Alan-JH/precision-clock/precision-clock-pcb/precision-clock.step

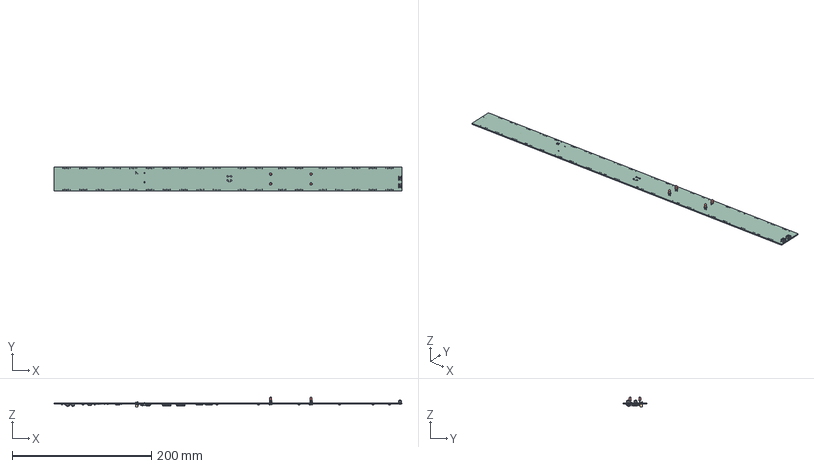
[picture p1: CAD file, 2025-11-18]
precision-clock-pcb/precision-clock.step
500.0 x 34.0 x 14.4 mm
SW_SPST_PTS647Sx38 x 4
LED_D3.0mm x 4
SOT-23 x 14
C_0402_1005Metric x 28
R_0402_1005Metric x 56
C_0603_1608Metric x 2
SOIC-8_5.3x5.3mm_P1.27mm
C_0805_2012Metric x 3
SOIC-8_3.9x4.9mm_P1.27mm
SOIC-20W_7.5x12.8mm_P1.27mm x 2
LED_0603_1608Metric
SOT-666
SOIC-16_3.9x9.9mm_P1.27mm x 2
SOT-223
Crystal_SMD_3225-4Pin_3.2x2.5mm
MMCX_Molex_73415-1471_Vertical
precision-clock_PCB
