Alan-JH/precision-clock/precision-clock-pcb/precision-clock.kicad_pcb

## KiCad design precision-clock-pcb/precision-clock.kicad_pcb (2025-11-18)

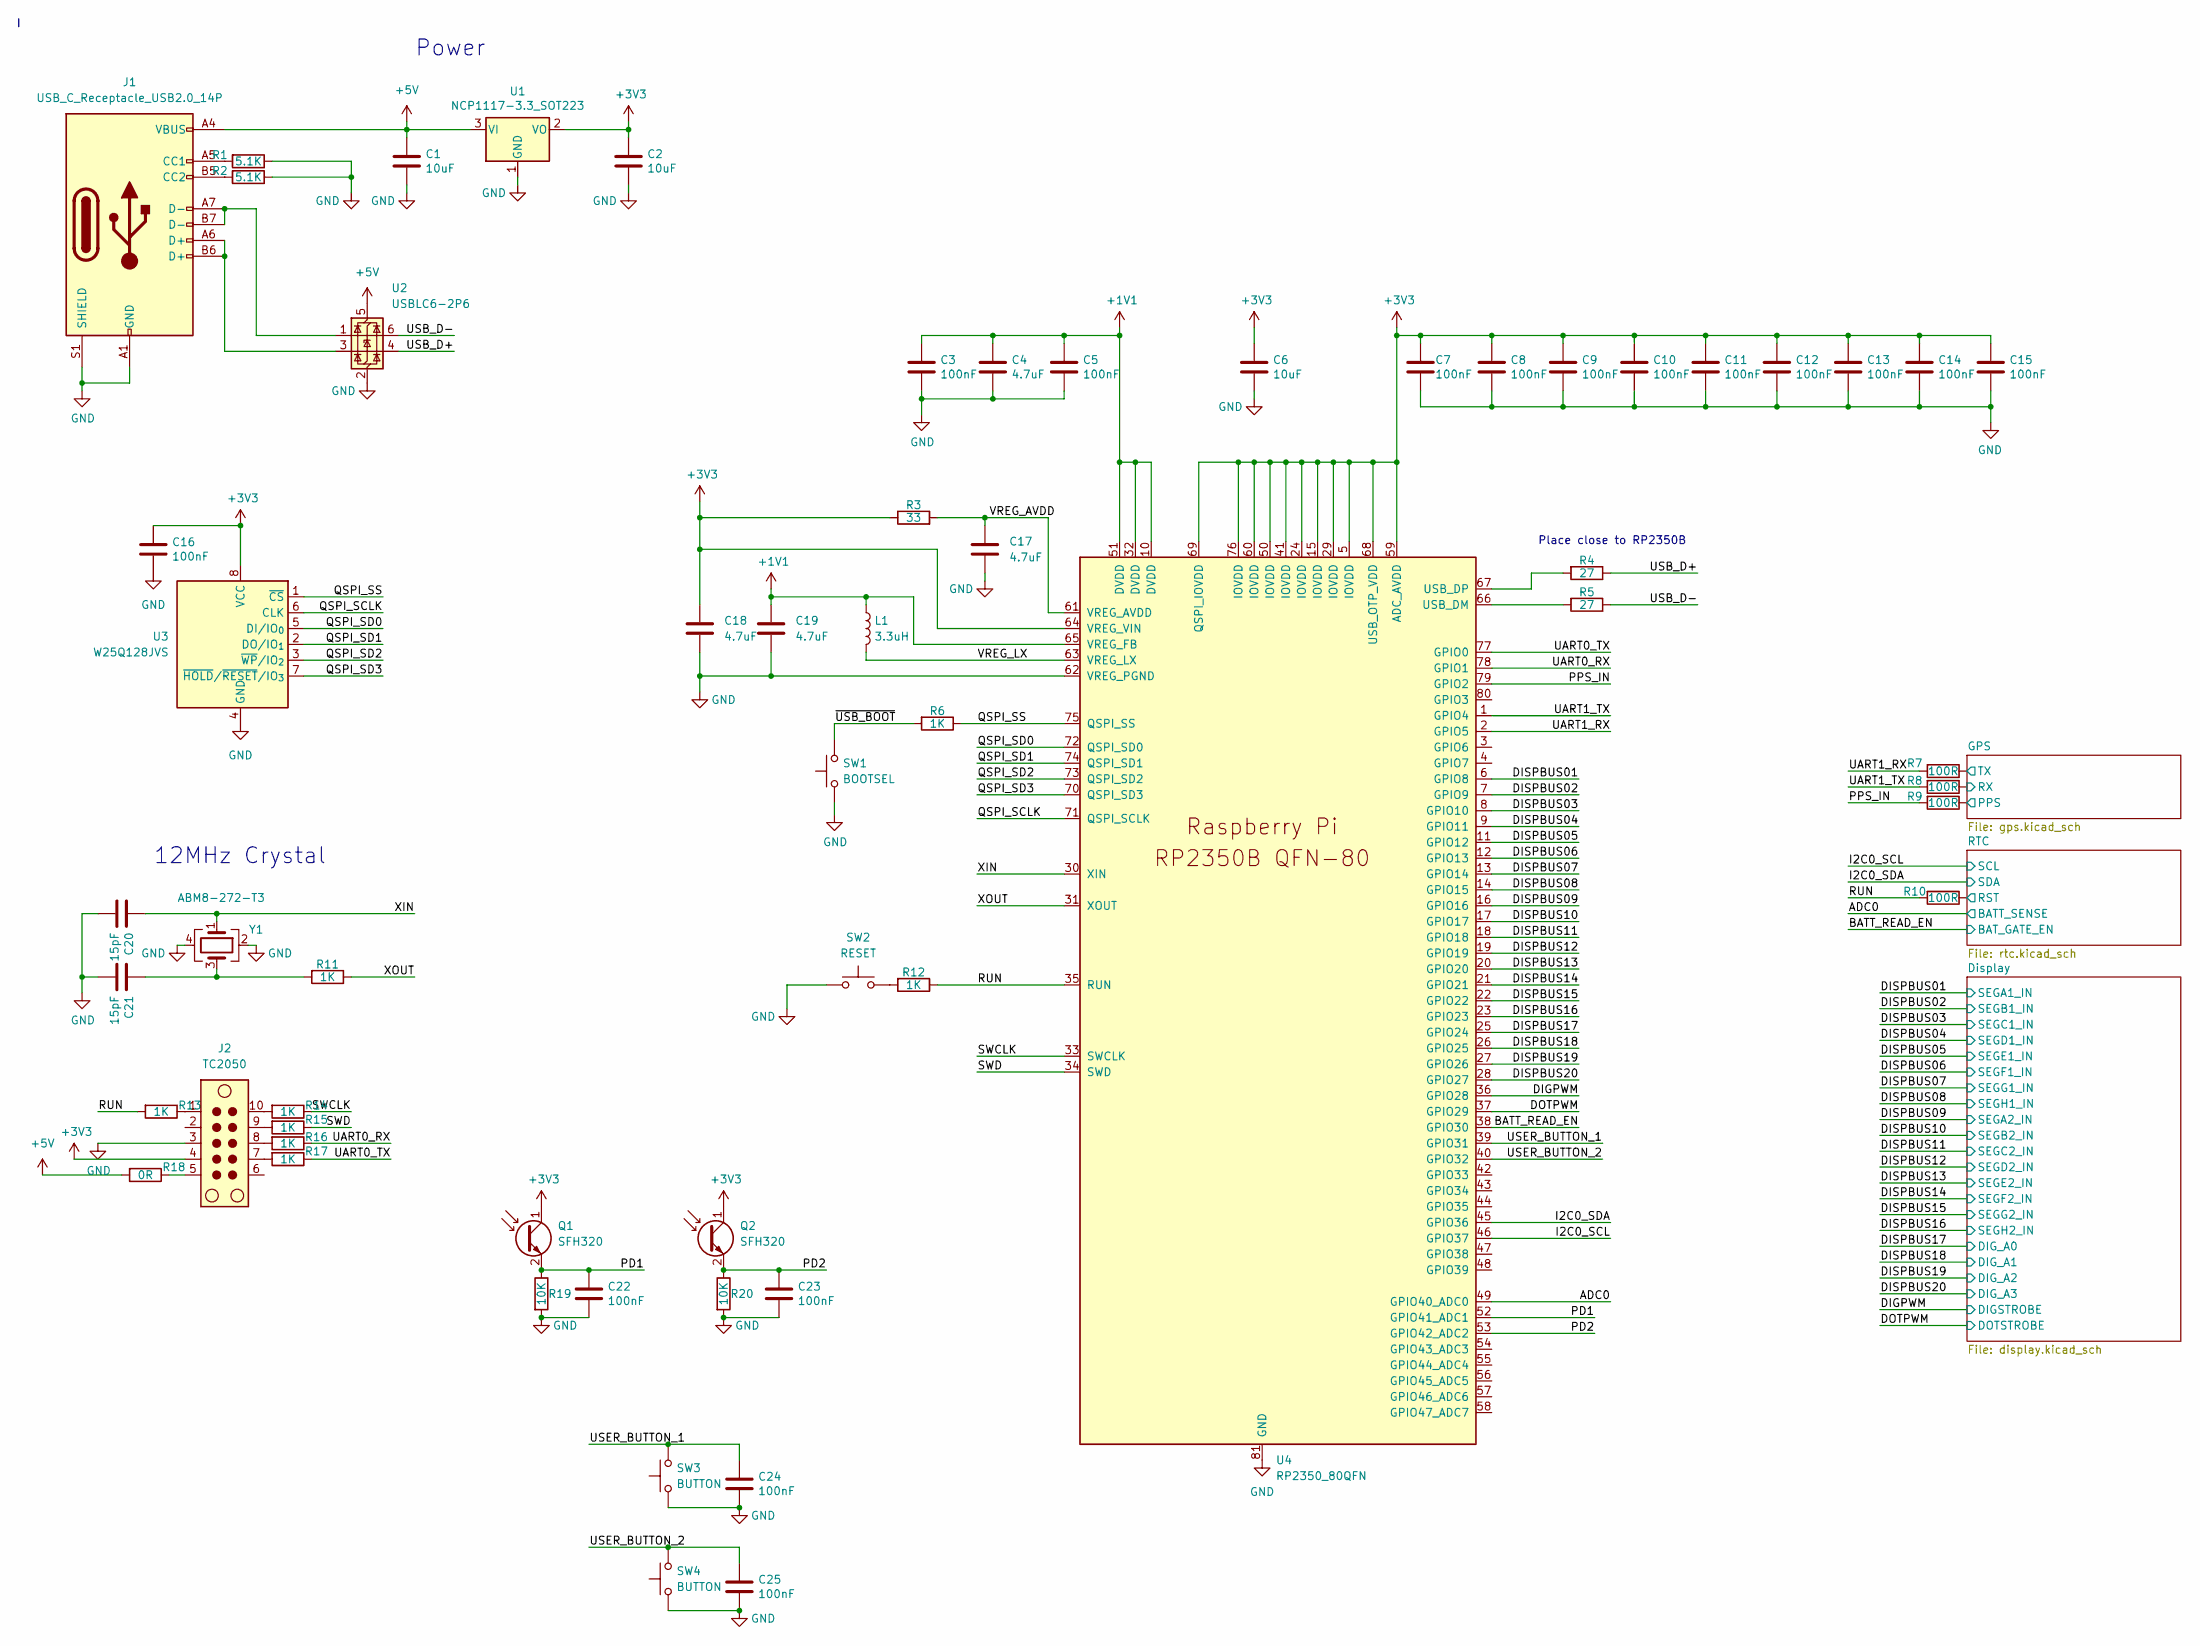
[picture p2: schematic precision-clock.kicad_sch]

Parts:
C1, C2, C6: 10uF; C_0805_2012Metric; MFR PN CL21B106KPQNNNE; JLCPCB PN C32635
C3, C5, C7, C8, C9, C10, C11, C12, C13, C14, C15, C16, C22, C23, C24, C25: 100nF; C_0402_1005Metric; MFR PN GRM155R71E104KE14D; JLCPCB PN C77014
C4, C17: 4.7uF; C_0402_1005Metric; MFR PN GRM155R61A475KEAAD; JLCPCB PN C77004
C18, C19: 4.7uF; C_0402_1005Metric_small_pads; MFR PN GRM155R61A475KEAAD; JLCPCB PN C77004
C20, C21: 15pF; C_0402_1005Metric; MFR PN CGA2B2C0G1H150JT0Y0F; JLCPCB PN C338103
J1: USB_C_Receptacle_USB2.0_14P; USB_C_Receptacle_G-Switch_GT-USB-7010ASV; MFR PN GT-USB-7010ASV; JLCPCB PN C2988369
J2: TC2050; Tag-Connect_TC2050-IDC-FP_2x05_P1.27mm_Vertical
L1: 3.3uH; L_pol_2016; MFR PN AOTA-B201610S3R3-101-T; JLCPCB PN C42411119
Q1, Q2: SFH320; LED_PLCC-2_3.4x3.0mm_KA; MFR PN SFH 320; JLCPCB PN C2900269
R1, R2: 5.1K; R_0402_1005Metric; MFR PN RC0402FR-075K1L; JLCPCB PN C105872
R3: 33; R_0402_1005Metric; MFR PN RC0402FR-0733RL; JLCPCB PN C138002
R4, R5: 27; R_0402_1005Metric; MFR PN RC0402FR-0727RL; JLCPCB PN C138021
R6, R11, R12, R13, R14, R15, R16, R17: 1K; R_0402_1005Metric; MFR PN RC0402FR-071KL; JLCPCB PN C106235
R7, R8, R9, R10: 100R; R_0402_1005Metric; MFR PN RC0402FR-07100RL; JLCPCB PN C106232
R18: 0R; R_0402_1005Metric; MFR PN RC0402FR-070RL; JLCPCB PN C106231
R19, R20: 10K; R_0402_1005Metric; MFR PN RC0402FR-0710KL; JLCPCB PN C60490
SW1: BOOTSEL; SW_SPST_PTS647_Sx38; MFR PN PTS647SK38SMTR2 LFS; JLCPCB PN C2798978
SW2: RESET; SW_SPST_PTS647_Sx38; MFR PN PTS647SK38SMTR2 LFS; JLCPCB PN C2798978
SW3, SW4: BUTTON; SW_SPST_PTS647_Sx38; MFR PN PTS647SK38SMTR2 LFS; JLCPCB PN C2798978
U1: NCP1117-3.3_SOT223; SOT-223-3_TabPin2; MFR PN LM1117MPX-3.3/NOPB; JLCPCB PN C9662
U2: USBLC6-2P6; SOT-666; MFR PN USBLC6-2P6; JLCPCB PN C15999
U3: W25Q128JVS; SOIC-8_5.3x5.3mm_P1.27mm; MFR PN W25Q128JVSIQ; JLCPCB PN C97521
U4: RP2350_80QFN; RP2350-QFN-80-1EP_10x10_P0.4mm_EP3.4x3.4mm_ThermalVias; MFR PN RP2350B; JLCPCB PN C42415655
Y1: ABM8-272-T3; Crystal_SMD_3225-4Pin_3.2x2.5mm; MFR PN ABM8-272-T3; JLCPCB PN C20625731

Connections:
+1V1: C3.1, C4.1, C5.1, C19.1, L1.1, U4.10 (DVDD), U4.32 (DVDD), U4.51 (DVDD), U4.65 (VREG_FB)
+3V3: C2.1, C6.1, C7.1, C8.1, C9.1, C10.1, C11.1, C12.1, C13.1, C14.1, C15.1, C16.1, C18.1, J2.4, Q1.1 (C), Q2.1 (C), R3.1, U1.2 (VO), U3.8 (VCC), U4.5 (IOVDD), U4.15 (IOVDD), U4.24 (IOVDD), U4.29 (IOVDD), U4.41 (IOVDD), U4.50 (IOVDD), U4.59 (ADC_AVDD), U4.60 (IOVDD), U4.64 (VREG_VIN), U4.68 (USB_OTP_VDD), U4.69 (QSPI_IOVDD), U4.76 (IOVDD); also elsewhere on the board
+5V: C1.1, J1.A4 (VBUS), J1.A9 (VBUS), J1.B4 (VBUS), J1.B9 (VBUS), R18.2, U1.3 (VI), U2.5 (VBUS); also elsewhere on the board
/ADC0: U4.49 (GPIO40_ADC0); also elsewhere on the board
/BATT_READ_EN: U4.38 (GPIO30); also elsewhere on the board
/DIGPWM: U4.36 (GPIO28); also elsewhere on the board
/DISPBUS01: U4.6 (GPIO8); also elsewhere on the board
/DISPBUS02: U4.7 (GPIO9); also elsewhere on the board
/DISPBUS03: U4.8 (GPIO10); also elsewhere on the board
/DISPBUS04: U4.9 (GPIO11); also elsewhere on the board
/DISPBUS05: U4.11 (GPIO12); also elsewhere on the board
/DISPBUS06: U4.12 (GPIO13); also elsewhere on the board
/DISPBUS07: U4.13 (GPIO14); also elsewhere on the board
/DISPBUS08: U4.14 (GPIO15); also elsewhere on the board
/DISPBUS09: U4.16 (GPIO16); also elsewhere on the board
/DISPBUS10: U4.17 (GPIO17); also elsewhere on the board
/DISPBUS11: U4.18 (GPIO18); also elsewhere on the board
/DISPBUS12: U4.19 (GPIO19); also elsewhere on the board
/DISPBUS13: U4.20 (GPIO20); also elsewhere on the board
/DISPBUS14: U4.21 (GPIO21); also elsewhere on the board
/DISPBUS15: U4.22 (GPIO22); also elsewhere on the board
/DISPBUS16: U4.23 (GPIO23); also elsewhere on the board
/DISPBUS17: U4.25 (GPIO24); also elsewhere on the board
/DISPBUS18: U4.26 (GPIO25); also elsewhere on the board
/DISPBUS19: U4.27 (GPIO26); also elsewhere on the board
/DISPBUS20: U4.28 (GPIO27); also elsewhere on the board
/DOTPWM: U4.37 (GPIO29); also elsewhere on the board
/GPS/PPS: R9.1; also elsewhere on the board
/GPS/RX: R8.1; also elsewhere on the board
/GPS/TX: R7.1; also elsewhere on the board
/I2C0_SCL: U4.46 (GPIO37); also elsewhere on the board
/I2C0_SDA: U4.45 (GPIO36); also elsewhere on the board
/PD1: C22.1, Q1.2 (E), R19.1, U4.52 (GPIO41_ADC1)
/PD2: C23.1, Q2.2 (E), R20.1, U4.53 (GPIO42_ADC2)
/PPS_IN: R9.2, U4.79 (GPIO2)
/QSPI_SCLK: U3.6 (CLK), U4.71 (QSPI_SCLK)
/QSPI_SD0: U3.5 (DI/IO_{0}), U4.72 (QSPI_SD0)
/QSPI_SD1: U3.2 (DO/IO_{1}), U4.74 (QSPI_SD1)
/QSPI_SD2: U3.3 (~WP/IO_{2}), U4.73 (QSPI_SD2)
/QSPI_SD3: U3.7 (~HOLD/~RESET/IO_{3}), U4.70 (QSPI_SD3)
/QSPI_SS: R6.1, U3.1 (~CS), U4.75 (QSPI_SS)
/RTC/RST: R10.1; also elsewhere on the board
/RUN: R10.2, R12.1, R13.2, U4.35 (RUN)
/SWCLK: R14.1, U4.33 (SWCLK)
/SWD: R15.1, U4.34 (SWD)
/UART0_RX: R16.1, U4.78 (GPIO1)
/UART0_TX: R17.1, U4.77 (GPIO0)
/UART1_RX: R7.2, U4.2 (GPIO5)
/UART1_TX: R8.2, U4.1 (GPIO4)
/USB_D+: R4.1, U2.4 (I/O2)
/USB_D-: R5.1, U2.6 (I/O1)
/USER_BUTTON_1: C24.1, SW3.2, U4.39 (GPIO31)
/USER_BUTTON_2: C25.1, SW4.2, U4.40 (GPIO32)
/VREG_AVDD: C17.1, R3.2, U4.61 (VREG_AVDD)
/VREG_LX: L1.2, U4.63 (VREG_LX)
/XIN: C20.1, U4.30 (XIN), Y1.1
/XOUT: R11.1, U4.31 (XOUT)
/~USB_BOOT: R6.2, SW1.2
GND: C1.2, C2.2, C3.2, C4.2, C5.2, C6.2, C7.2, C8.2, C9.2, C10.2, C11.2, C12.2, C13.2, C14.2, C15.2, C16.2, C17.2, C18.2, C19.2, C20.2, C21.2, C22.2, C23.2, C24.2, C25.2, J1.A1 (GND), J1.A12 (GND), J1.B1 (GND), J1.B12 (GND), J1.S1 (SHIELD), J2.3, R1.1, R2.1, R19.2, R20.2, SW1.1, SW2.1, SW3.1, SW4.1, U1.1 (GND), U2.2 (GND), U3.4 (GND), U4.62 (VREG_PGND), U4.81 (GND), Y1.2, Y1.4; also elsewhere on the board
unnamed: C21.1, R11.2, Y1.3
unnamed: J1.A5 (CC1), R1.2
unnamed: J1.B5 (CC2), R2.2
unnamed: J1.A6 (D+), J1.B6 (D+), U2.3 (I/O2)
unnamed: J1.A7 (D-), J1.B7 (D-), U2.1 (I/O1)
unnamed: J2.1, R13.1
unnamed: J2.5, R18.1
unnamed: J2.7, R17.2
unnamed: J2.8, R16.2
unnamed: J2.9, R15.2
unnamed: J2.10, R14.2
unnamed: R12.2, SW2.2
unnamed: R5.2, U4.66 (USB_DM)
unnamed: R4.2, U4.67 (USB_DP)

Notes on the sheet:
12MHz Crystal
Place close to RP2350B
Power

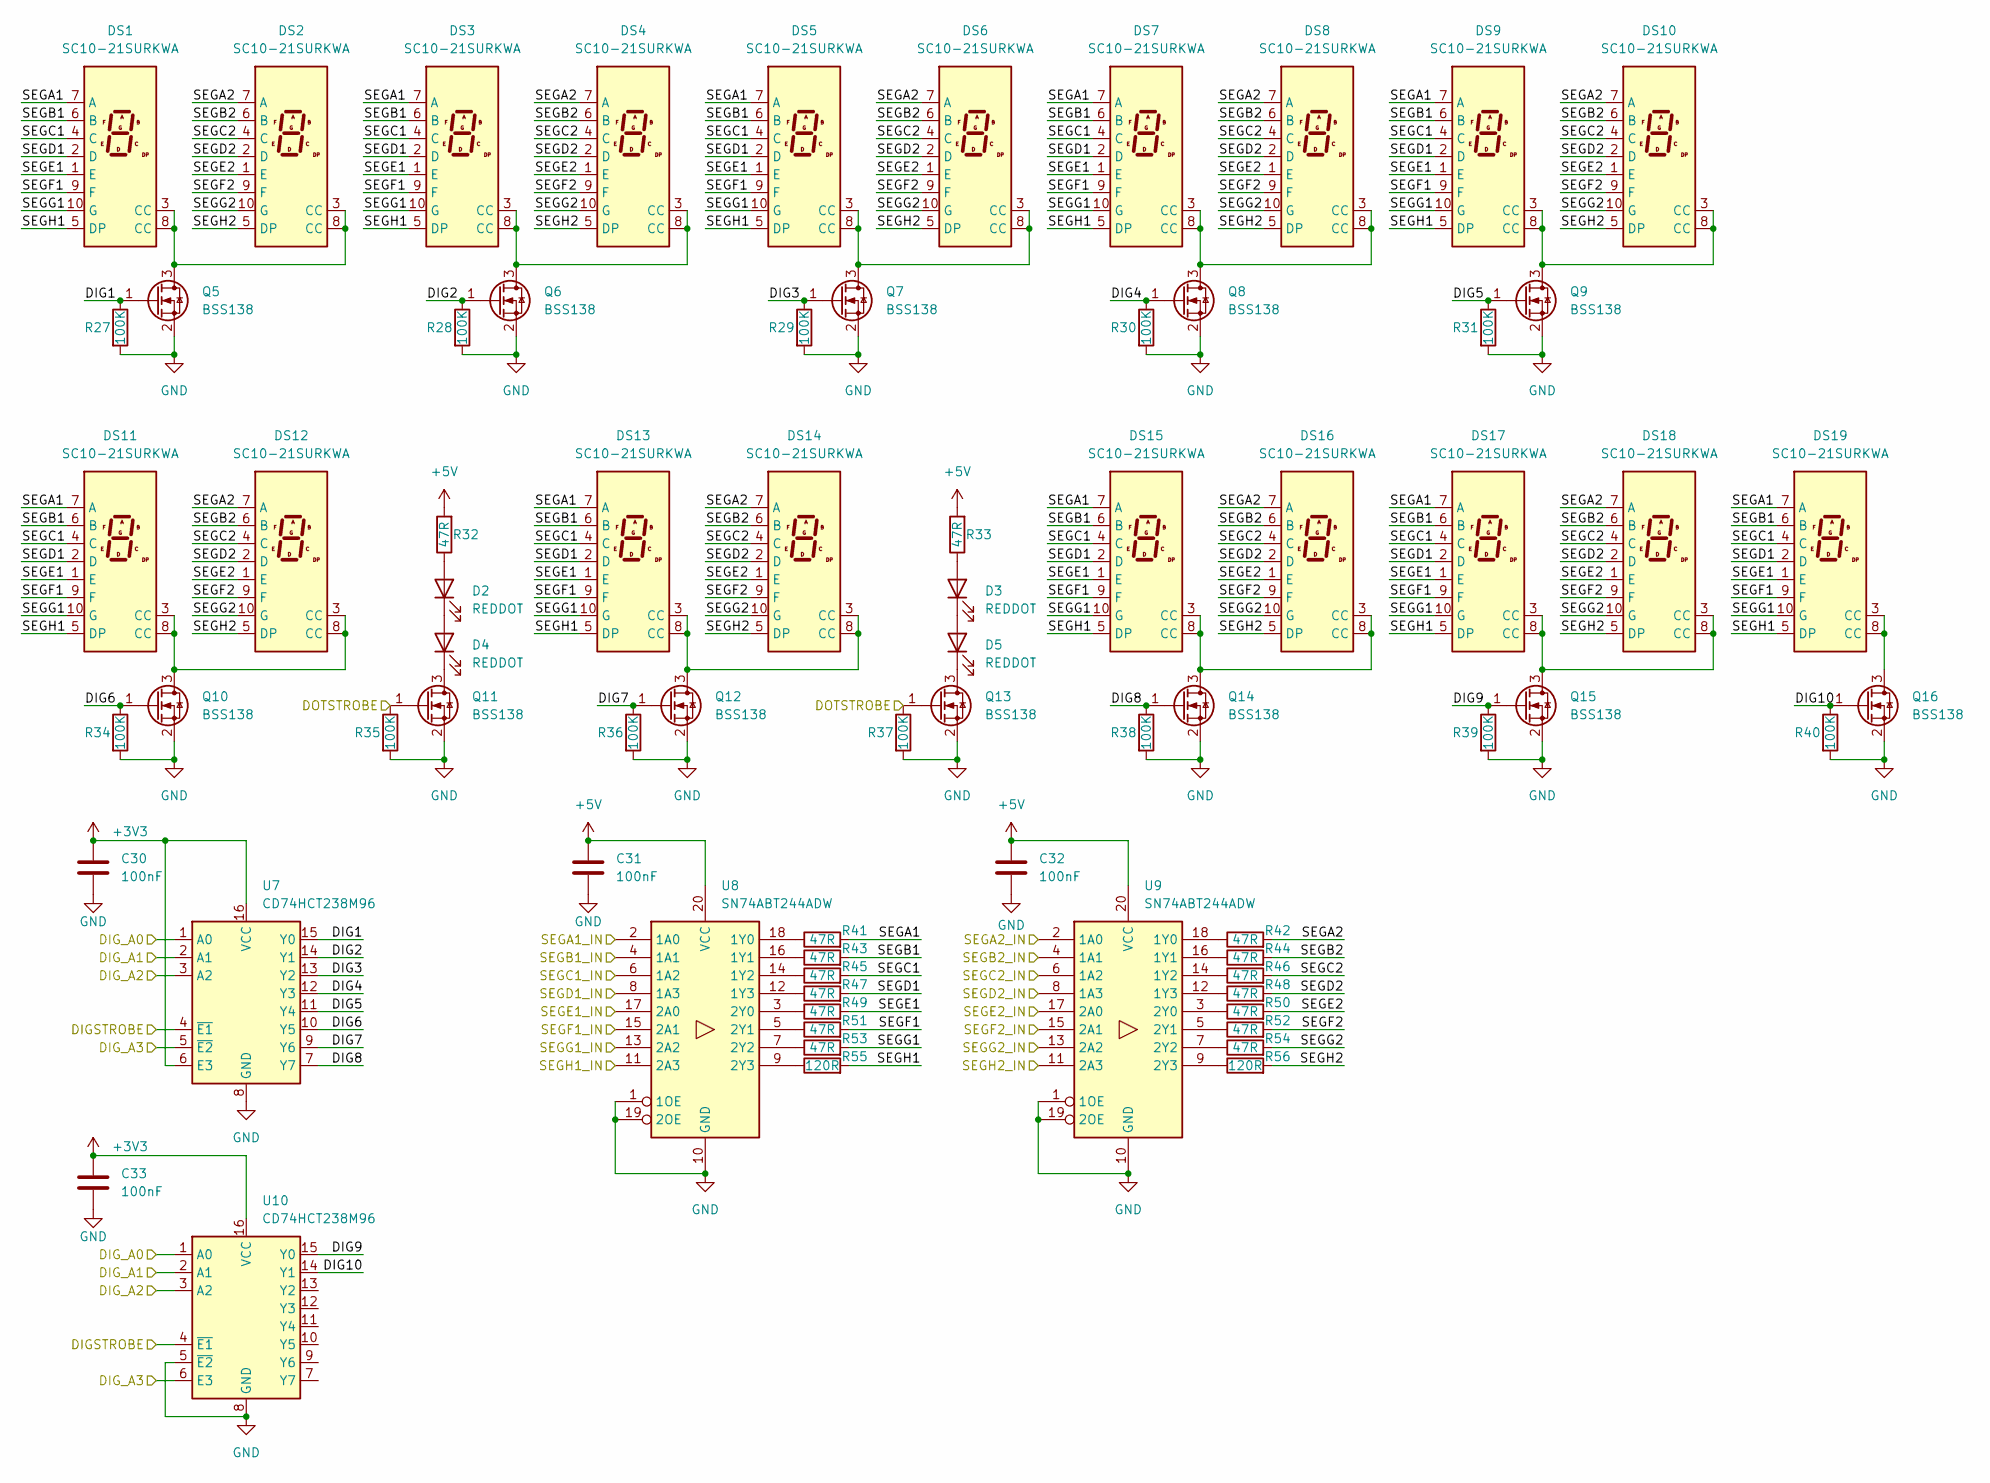
[picture p3: schematic display.kicad_sch]

Parts:
C30, C31, C32, C33: 100nF; C_0402_1005Metric; MFR PN GRM155R71E104KE14D; JLCPCB PN C77014
D2, D3, D4, D5: REDDOT; LED_D3.0mm; MFR PN 204-10SURD/S530-A3-L; JLCPCB PN C99771
DS1, DS2, DS3, DS4, DS5, DS6, DS7, DS8, DS9, DS10, DS11, DS12, DS13, DS14, DS15, DS16, DS17, DS18, DS19: SC10-21SURKWA; MFR PN SC10-21SURKWA; JLCPCB PN C6472270
Q5, Q6, Q7, Q8, Q9, Q10, Q11, Q12, Q13, Q14, Q15, Q16: BSS138; SOT-23; MFR PN BSS138; JLCPCB PN C52895
R27, R28, R29, R30, R31, R34, R35, R36, R37, R38, R39, R40: 100K; R_0402_1005Metric; MFR PN RC0402FR-07100KL; JLCPCB PN C60491
R32, R33, R41, R42, R43, R44, R45, R46, R47, R48, R49, R50, R51, R52, R53, R54: 47R; R_0402_1005Metric; MFR PN RC0402FR-0747RL; JLCPCB PN C137973
R55, R56: 120R; R_0402_1005Metric; MFR PN RC0402FR-07120RL; JLCPCB PN C114758
U7, U10: CD74HCT238M96; SOIC-16_3.9x9.9mm_P1.27mm; MFR PN CD74HCT238M96; JLCPCB PN C553161
U8, U9: SN74ABT244ADW; SOIC-20W_7.5x12.8mm_P1.27mm; MFR PN SN74ABT244ADWR; JLCPCB PN C2675811

Connections:
+3V3: C30.1, C33.1, U7.6 (E3), U7.16 (VCC), U10.16 (VCC); also elsewhere on the board
+5V: C31.1, C32.1, R32.2, R33.2, U8.20 (VCC), U9.20 (VCC); also elsewhere on the board
/DIGPWM: U7.4 (~E1), U10.4 (~E1); also elsewhere on the board
/DISPBUS01: U8.2 (1A0); also elsewhere on the board
/DISPBUS02: U8.4 (1A1); also elsewhere on the board
/DISPBUS03: U8.6 (1A2); also elsewhere on the board
/DISPBUS04: U8.8 (1A3); also elsewhere on the board
/DISPBUS05: U8.17 (2A0); also elsewhere on the board
/DISPBUS06: U8.15 (2A1); also elsewhere on the board
/DISPBUS07: U8.13 (2A2); also elsewhere on the board
/DISPBUS08: U8.11 (2A3); also elsewhere on the board
/DISPBUS09: U9.2 (1A0); also elsewhere on the board
/DISPBUS10: U9.4 (1A1); also elsewhere on the board
/DISPBUS11: U9.6 (1A2); also elsewhere on the board
/DISPBUS12: U9.8 (1A3); also elsewhere on the board
/DISPBUS13: U9.17 (2A0); also elsewhere on the board
/DISPBUS14: U9.15 (2A1); also elsewhere on the board
/DISPBUS15: U9.13 (2A2); also elsewhere on the board
/DISPBUS16: U9.11 (2A3); also elsewhere on the board
/DISPBUS17: U7.1 (A0), U10.1 (A0); also elsewhere on the board
/DISPBUS18: U7.2 (A1), U10.2 (A1); also elsewhere on the board
/DISPBUS19: U7.3 (A2), U10.3 (A2); also elsewhere on the board
/DISPBUS20: U7.5 (~E2), U10.6 (E3); also elsewhere on the board
/DOTPWM: Q11.1 (G), Q13.1 (G), R35.1, R37.1; also elsewhere on the board
/Display/DIG1: Q5.1 (G), R27.1, U7.15 (Y0)
/Display/DIG2: Q6.1 (G), R28.1, U7.14 (Y1)
/Display/DIG3: Q7.1 (G), R29.1, U7.13 (Y2)
/Display/DIG4: Q8.1 (G), R30.1, U7.12 (Y3)
/Display/DIG5: Q9.1 (G), R31.1, U7.11 (Y4)
/Display/DIG6: Q10.1 (G), R34.1, U7.10 (Y5)
/Display/DIG7: Q12.1 (G), R36.1, U7.9 (Y6)
/Display/DIG8: Q14.1 (G), R38.1, U7.7 (Y7)
/Display/DIG9: Q15.1 (G), R39.1, U10.15 (Y0)
/Display/DIG10: Q16.1 (G), R40.1, U10.14 (Y1)
/Display/SEGA1: DS1.7 (A), DS3.7 (A), DS5.7 (A), DS7.7 (A), DS9.7 (A), DS11.7 (A), DS13.7 (A), DS15.7 (A), DS17.7 (A), DS19.7 (A), R41.2
/Display/SEGA2: DS2.7 (A), DS4.7 (A), DS6.7 (A), DS8.7 (A), DS10.7 (A), DS12.7 (A), DS14.7 (A), DS16.7 (A), DS18.7 (A), R42.2
/Display/SEGB1: DS1.6 (B), DS3.6 (B), DS5.6 (B), DS7.6 (B), DS9.6 (B), DS11.6 (B), DS13.6 (B), DS15.6 (B), DS17.6 (B), DS19.6 (B), R43.2
/Display/SEGB2: DS2.6 (B), DS4.6 (B), DS6.6 (B), DS8.6 (B), DS10.6 (B), DS12.6 (B), DS14.6 (B), DS16.6 (B), DS18.6 (B), R44.2
/Display/SEGC1: DS1.4 (C), DS3.4 (C), DS5.4 (C), DS7.4 (C), DS9.4 (C), DS11.4 (C), DS13.4 (C), DS15.4 (C), DS17.4 (C), DS19.4 (C), R45.2
/Display/SEGC2: DS2.4 (C), DS4.4 (C), DS6.4 (C), DS8.4 (C), DS10.4 (C), DS12.4 (C), DS14.4 (C), DS16.4 (C), DS18.4 (C), R46.2
/Display/SEGD1: DS1.2 (D), DS3.2 (D), DS5.2 (D), DS7.2 (D), DS9.2 (D), DS11.2 (D), DS13.2 (D), DS15.2 (D), DS17.2 (D), DS19.2 (D), R47.2
/Display/SEGD2: DS2.2 (D), DS4.2 (D), DS6.2 (D), DS8.2 (D), DS10.2 (D), DS12.2 (D), DS14.2 (D), DS16.2 (D), DS18.2 (D), R48.2
/Display/SEGE1: DS1.1 (E), DS3.1 (E), DS5.1 (E), DS7.1 (E), DS9.1 (E), DS11.1 (E), DS13.1 (E), DS15.1 (E), DS17.1 (E), DS19.1 (E), R49.2
/Display/SEGE2: DS2.1 (E), DS4.1 (E), DS6.1 (E), DS8.1 (E), DS10.1 (E), DS12.1 (E), DS14.1 (E), DS16.1 (E), DS18.1 (E), R50.2
/Display/SEGF1: DS1.9 (F), DS3.9 (F), DS5.9 (F), DS7.9 (F), DS9.9 (F), DS11.9 (F), DS13.9 (F), DS15.9 (F), DS17.9 (F), DS19.9 (F), R51.2
/Display/SEGF2: DS2.9 (F), DS4.9 (F), DS6.9 (F), DS8.9 (F), DS10.9 (F), DS12.9 (F), DS14.9 (F), DS16.9 (F), DS18.9 (F), R52.2
/Display/SEGG1: DS1.10 (G), DS3.10 (G), DS5.10 (G), DS7.10 (G), DS9.10 (G), DS11.10 (G), DS13.10 (G), DS15.10 (G), DS17.10 (G), DS19.10 (G), R53.2
/Display/SEGG2: DS2.10 (G), DS4.10 (G), DS6.10 (G), DS8.10 (G), DS10.10 (G), DS12.10 (G), DS14.10 (G), DS16.10 (G), DS18.10 (G), R54.2
/Display/SEGH1: DS1.5 (DP), DS3.5 (DP), DS5.5 (DP), DS7.5 (DP), DS9.5 (DP), DS11.5 (DP), DS13.5 (DP), DS15.5 (DP), DS17.5 (DP), DS19.5 (DP), R55.2
/Display/SEGH2: DS2.5 (DP), DS4.5 (DP), DS6.5 (DP), DS8.5 (DP), DS10.5 (DP), DS12.5 (DP), DS14.5 (DP), DS16.5 (DP), DS18.5 (DP), R56.2
GND: C30.2, C31.2, C32.2, C33.2, Q5.2 (S), Q6.2 (S), Q7.2 (S), Q8.2 (S), Q9.2 (S), Q10.2 (S), Q11.2 (S), Q12.2 (S), Q13.2 (S), Q14.2 (S), Q15.2 (S), Q16.2 (S), R27.2, R28.2, R29.2, R30.2, R31.2, R34.2, R35.2, R36.2, R37.2, R38.2, R39.2, R40.2, U7.8 (GND), U8.1 (1OE), U8.10 (GND), U8.19 (2OE), U9.1 (1OE), U9.10 (GND), U9.19 (2OE), U10.5 (~E2), U10.8 (GND); also elsewhere on the board
unnamed: D2.2 (A), R32.1
unnamed: D2.1 (K), D4.2 (A)
unnamed: D3.2 (A), R33.1
unnamed: D3.1 (K), D5.2 (A)
unnamed: D4.1 (K), Q11.3 (D)
unnamed: D5.1 (K), Q13.3 (D)
unnamed: DS1.3 (CC), DS1.8 (CC), DS2.3 (CC), DS2.8 (CC), Q5.3 (D)
unnamed: DS3.3 (CC), DS3.8 (CC), DS4.3 (CC), DS4.8 (CC), Q6.3 (D)
unnamed: DS5.3 (CC), DS5.8 (CC), DS6.3 (CC), DS6.8 (CC), Q7.3 (D)
unnamed: DS7.3 (CC), DS7.8 (CC), DS8.3 (CC), DS8.8 (CC), Q8.3 (D)
unnamed: DS9.3 (CC), DS9.8 (CC), DS10.3 (CC), DS10.8 (CC), Q9.3 (D)
unnamed: DS11.3 (CC), DS11.8 (CC), DS12.3 (CC), DS12.8 (CC), Q10.3 (D)
unnamed: DS13.3 (CC), DS13.8 (CC), DS14.3 (CC), DS14.8 (CC), Q12.3 (D)
unnamed: DS15.3 (CC), DS15.8 (CC), DS16.3 (CC), DS16.8 (CC), Q14.3 (D)
unnamed: DS17.3 (CC), DS17.8 (CC), DS18.3 (CC), DS18.8 (CC), Q15.3 (D)
unnamed: DS19.3 (CC), DS19.8 (CC), Q16.3 (D)
unnamed: R41.1, U8.18 (1Y0)
unnamed: R43.1, U8.16 (1Y1)
unnamed: R45.1, U8.14 (1Y2)
unnamed: R47.1, U8.12 (1Y3)
unnamed: R49.1, U8.3 (2Y0)
unnamed: R51.1, U8.5 (2Y1)
unnamed: R53.1, U8.7 (2Y2)
unnamed: R55.1, U8.9 (2Y3)
unnamed: R42.1, U9.18 (1Y0)
unnamed: R44.1, U9.16 (1Y1)
unnamed: R46.1, U9.14 (1Y2)
unnamed: R48.1, U9.12 (1Y3)
unnamed: R50.1, U9.3 (2Y0)
unnamed: R52.1, U9.5 (2Y1)
unnamed: R54.1, U9.7 (2Y2)
unnamed: R56.1, U9.9 (2Y3)

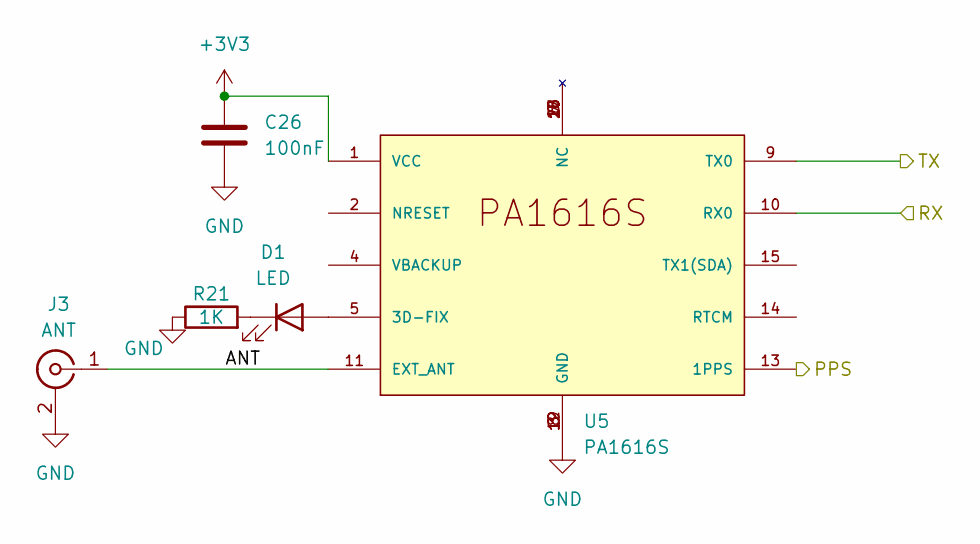
[picture p4: schematic gps.kicad_sch]

Parts:
C26: 100nF; C_0402_1005Metric; MFR PN GRM155R71E104KE14D; JLCPCB PN C77014
D1: LED; LED_0603_1608Metric; MFR PN 150060RS75000; JLCPCB PN C3030991
J3: ANT; MMCX_Molex_73415-1471_Vertical; MFR PN 0734151471; JLCPCB PN C588477
R21: 1K; R_0402_1005Metric; MFR PN RC0402FR-071KL; JLCPCB PN C106235
U5: PA1616S; MFR PN PA1616S

Connections:
+3V3: C26.1, U5.1 (VCC); also elsewhere on the board
/GPS/ANT: J3.1 (In), U5.11 (EXT_ANT)
/GPS/PPS: U5.13 (1PPS); also elsewhere on the board
/GPS/RX: U5.10 (RX0); also elsewhere on the board
/GPS/TX: U5.9 (TX0); also elsewhere on the board
GND: C26.2, J3.2 (Ext), R21.1, U5.3 (GND), U5.8 (GND), U5.12 (GND), U5.19 (GND); also elsewhere on the board
unnamed: D1.2 (A), U5.5 (3D-FIX)
unnamed: D1.1 (K), R21.2

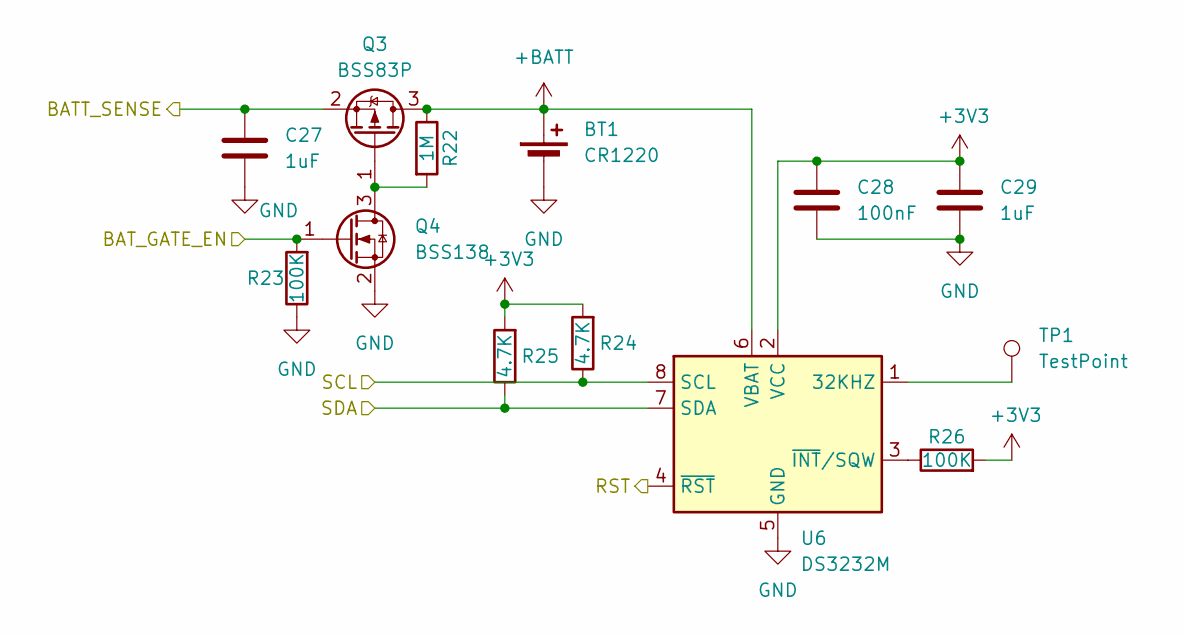
[picture p5: schematic rtc.kicad_sch]

Parts:
BT1: CR1220; BAT_2895; MFR PN 2895; JLCPCB PN C5495443
C27, C29: 1uF; C_0603_1608Metric; MFR PN CL10B105KA8NNNC; JLCPCB PN C29936
C28: 100nF; C_0402_1005Metric; MFR PN GRM155R71E104KE14D; JLCPCB PN C77014
Q3: BSS83P; SOT-23; MFR PN BSS83PH6327; JLCPCB PN C2932927
Q4: BSS138; SOT-23; MFR PN BSS138; JLCPCB PN C52895
R22: 1M; R_0402_1005Metric; MFR PN RC0402FR-071ML; JLCPCB PN C138033
R23, R26: 100K; R_0402_1005Metric; MFR PN RC0402FR-07100KL; JLCPCB PN C60491
R24, R25: 4.7K; R_0402_1005Metric; MFR PN RC0402FR-074K7L; JLCPCB PN C105871
TP1: TestPoint; TestPoint_Pad_2.0x2.0mm
U6: DS3232M; SOIC-8_3.9x4.9mm_P1.27mm; MFR PN DS3232MZ+TRL; JLCPCB PN C2827535

Connections:
+3V3: C28.1, C29.1, R24.2, R25.2, R26.2, U6.2 (VCC); also elsewhere on the board
+BATT: BT1.1 (+), Q3.3 (D), R22.1, U6.6 (VBAT)
/ADC0: C27.1, Q3.2 (S); also elsewhere on the board
/BATT_READ_EN: Q4.1 (G), R23.2; also elsewhere on the board
/I2C0_SCL: R24.1, U6.8 (SCL); also elsewhere on the board
/I2C0_SDA: R25.1, U6.7 (SDA); also elsewhere on the board
/RTC/RST: U6.4 (~RST); also elsewhere on the board
GND: BT1.2 (-), C27.2, C28.2, C29.2, Q4.2 (S), R23.1, U6.5 (GND); also elsewhere on the board
unnamed: Q3.1 (G), Q4.3 (D), R22.2
unnamed: TP1.1, U6.1 (32KHZ)
unnamed: R26.1, U6.3 (~INT/SQW)

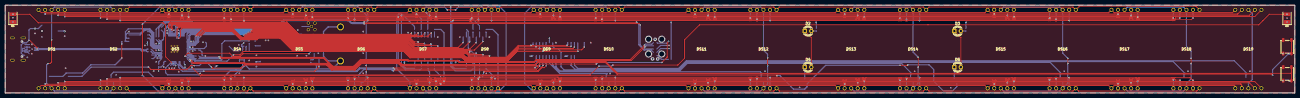
[picture p6: board precision-clock.kicad_pcb from above]

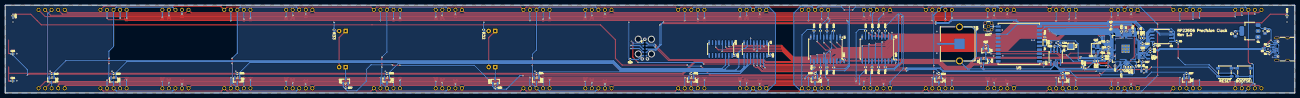
[picture p7: board precision-clock.kicad_pcb from below]

Board: 4 copper layers, 500.0 x 34.0 mm, 150 parts (123 on the bottom side), 138 nets.
