Alan-JH/precision-clock/firmware/src/gps/gps.c

/*
The MIT License (MIT)

Copyright (c) 2015 Jacob McGladdery https://github.com/JCube001/libgps

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
THE SOFTWARE IS PROVIDED "AS IS", WITHOUT WARRANTY OF ANY KIND, EXPRESS OR
IMPLIED, INCLUDING BUT NOT LIMITED TO THE WARRANTIES OF MERCHANTABILITY,
FITNESS FOR A PARTICULAR PURPOSE AND NONINFRINGEMENT. IN NO EVENT SHALL THE
AUTHORS OR COPYRIGHT HOLDERS BE LIABLE FOR ANY CLAIM, DAMAGES OR OTHER
LIABILITY, WHETHER IN AN ACTION OF CONTRACT, TORT OR OTHERWISE, ARISING FROM,
OUT OF OR IN CONNECTION WITH THE SOFTWARE OR THE USE OR OTHER DEALINGS IN
THE SOFTWARE.
*/

#include "gps.h"

#include <assert.h>
#include <stdbool.h>
#include <stddef.h>
#include <string.h>

#define NMEA_MAX_FIELDS  (32)
#define SENTENCE_ID_SIZE (3)

#define is_char_in_range(c, start, end) \
    (((uint_fast8_t)(c - start)) < ((uint_fast8_t)(end - start + 1)))

#define is_digit_0_to_1(c) is_char_in_range(c, '0', '1')
#define is_digit_0_to_2(c) is_char_in_range(c, '0', '2')
#define is_digit_0_to_3(c) is_char_in_range(c, '0', '3')
#define is_digit_0_to_5(c) is_char_in_range(c, '0', '5')
#define is_digit_0_to_9(c) is_char_in_range(c, '0', '9')

typedef uint8_t (*parse_function)(struct gps_tpv *, const char **);

static const char NULL_TIME[] = "0000-00-00T00:00:00.000Z";

static char uint8_to_hex_char(const uint8_t n)
{
    static const char hex[] = {
        '0', '1', '2', '3', '4', '5', '6', '7',
        '8', '9', 'A', 'B', 'C', 'D', 'E', 'F'
    };

    if ((0 <= n) && (n <= 0x0F)) return hex[n];
    return hex[0];
}

static uint8_t hex_char_to_uint8(const char c)
{
    if (('0' <= c) && (c <= '9'))
        return c - '0';
    else if (('A' <= c) && (c <= 'F'))
        return c - 'A' + 10;
    else if (('a' <= c) && (c <= 'f'))
        return c - 'a' + 10;

    return 0;
}

static uint8_t build_hex_byte(const char c0, const char c1)
{
    uint8_t val;
    val  = (hex_char_to_uint8(c0) << 4) & 0xF0;
    val |=  hex_char_to_uint8(c1)       & 0x0F;
    return val;
}

static bool match_sentence_id(const char *str, const char *id)
{
    return strncmp(str, id, SENTENCE_ID_SIZE) == 0;
}

static int32_t parse_number(const char *str)
{
    int32_t value = 0;
    int32_t factor;
    int32_t sign = 1;
    char c0 = *str++;

    /* Check if the string is an empty token field */
    if (!c0) return GPS_INVALID_VALUE;

    /* Number : -?[0-9]+(\.[0-9]{1,3}) */

    /* Check if the first character is a minus sign
     * Regex : -?
     */
    if ('-' == c0)
    {
        sign = -1;
        c0 = *str++;
    }

    /* Store one or more decimal digits
     * Regex : [0-9]+
     */
    if (is_digit_0_to_9(c0))
    {
        do
        {
            value = (value * 10) + (c0 - '0');
            c0 = *str++;
        }
        while (is_digit_0_to_9(c0));
    }
    else
    {
        return GPS_INVALID_VALUE;
    }

    /* Check for a decimal point. If one is present, then store up to 3 digits
     * past it.
     * Regex : (\.[0-9]{1,3})
     */
    factor = GPS_VALUE_FACTOR;
    if ('.' == c0)
    {
        c0 = *str++;
        if (is_digit_0_to_9(c0))
        {
            uint_fast8_t i = 3;

            do
            {
                value = (value * 10) + (c0 - '0');
                factor /= 10;
                c0 = *str++;
            }
            while (is_digit_0_to_9(c0) && --i);
        }
    }

    return value * factor * sign;
}

static int32_t parse_angular_distance(const char *nmea, const char direction)
{
    int32_t angular_distance;
    int32_t minutes;
    int32_t factor;
    int32_t sign;
    uint_fast8_t i;
    char c0 = *nmea++;

    /* First check for an empty token field */
    if (!c0) return GPS_INVALID_VALUE;

    /* Latitude  : ([0-9]{2})([0-9]{2}\.)[0-9]{1,6}
     * Longitude : ([0-9]{3})([0-9]{2}\.)[0-9]{1,6}
     *
     * Northing  : N = +, S = -
     * Easting   : E = +, W = -
     */

    /* Convert the direction to a sign. Also set the number of digits to treat
     * as decimal degrees. For N or S, we know we are parsing latitude and
     * that begins with 2 degree digits. For E or W, we know we are parsing
     * longitude and that begins with 3 degree digits.
     */
    switch (direction)
    {
    case 'N':
        sign = 1;
        i = 2;
        break;
    case 'S':
        sign = -1;
        i = 2;
        break;
    case 'E':
        sign = 1;
        i = 3;
        break;
    case 'W':
        sign = -1;
        i = 3;
        break;
    default:
        return GPS_INVALID_VALUE;
    }

    /* Store the first 3 digits which are already in decimal degrees
     * Regex : ([0-9]{3})
     */
    angular_distance = 0;
    while (i--)
    {
        if (is_digit_0_to_9(c0))
        {
            angular_distance = (angular_distance * 10) + (c0 - '0');
            c0 = *nmea++;
        }
        else
        {
            return GPS_INVALID_VALUE;
        }
    }
    angular_distance *= GPS_LAT_LON_FACTOR;

    /* Store the next two digits which are part of the arc minutes
     * Regex : ([0-9]{2}\.)
     */
    minutes = 0;
    i = 2;
    while (i--)
    {
        if (is_digit_0_to_9(c0))
        {
            minutes = (minutes * 10) + (c0 - '0');
            c0 = *nmea++;
        }
        else
        {
            return GPS_INVALID_VALUE;
        }
    }

    /* Check if a decimal point is the current character */
    if (c0 != '.') return GPS_INVALID_VALUE;
    c0 = *nmea++;

    /* Store up to 6 more arc minute fraction values
     * Regex : [0-9]{1,6}
     */
    factor = GPS_LAT_LON_FACTOR;
    i = 6;
    if (is_digit_0_to_9(c0))
    {
        do
        {
            minutes = (minutes * 10) + (c0 - '0');
            factor /= 10;
            c0 = *nmea++;
        }
        while (is_digit_0_to_9(c0) && --i);
    }
    else
    {
        return GPS_INVALID_VALUE;
    }
    minutes *= factor;

    /* Divide the arc minutes by 60 to get the decimal degrees fraction */
    minutes /= 60;

    /* Add the decimal degrees to the fraction component. We now how an
     * integer value which represents latitude in decimal degrees times
     * 10^6.
     */
    angular_distance += minutes;

    return angular_distance * sign;
}

static uint8_t parse_time(Time *destination, const char *nmea)
{
    char c0 = *nmea++;

    /* ISO8601 : YYYY-MM-DDTHH:MM:SS.SSSZ
     * NMEA    : HHMMSS.SSS
     * Regex   : ([0-2][0-9])([0-5][0-9])([0-5][0-9])(\.[0-9]{1,3})?
     */

    /* ([0-2][0-9]) */
    if (is_digit_0_to_2(c0))
    {
        destination->hours = 10 * (uint8_t)(c0 - '0'); /* H */
        c0 = *nmea++;
    }
    else
    {
        return 1;
    }

    if (is_digit_0_to_9(c0))
    {
        destination->hours += (uint8_t)(c0 - '0'); /* H */
        c0 = *nmea++;
    }
    else
    {
        return 1;
    }

    /* ([0-5][0-9]) */
    if (is_digit_0_to_5(c0))
    {
        destination->minutes = 10 * (uint8_t)(c0 - '0'); /* M */
        c0 = *nmea++;
    }
    else
    {
        return 1;
    }

    if (is_digit_0_to_9(c0))
    {
        destination->minutes += (uint8_t)(c0 - '0'); /* M */
        c0 = *nmea++;
    }
    else
    {
        return 1;
    }

    /* ([0-5][0-9]) */
    if (is_digit_0_to_5(c0))
    {
        destination->seconds = 10 * (uint8_t)(c0 - '0'); /* S */
        c0 = *nmea++;
    }
    else
    {
        return 1;
    }

    if (is_digit_0_to_9(c0))
    {
        destination->seconds += (uint8_t)(c0 - '0'); /* S */
        c0 = *nmea++;
    }
    else
    {
        return 1;
    }

    /* (\.[0-9]{1,3})? */
    destination->milliseconds = 0;
    if ('.' == c0)
    {
        uint_fast8_t i;

        /* Advance the destination pointer past the decimal point */
        destination += 20;
        c0 = *nmea++;
        uint8_t factor = 100;
        for (i = 0; is_digit_0_to_9(c0) && (i < 3); ++i)
        {
            destination->milliseconds += (uint8_t)(c0 - '0') * factor;
            factor /= 10;
            c0 = *nmea++;
        }
    }
    return 0;
}

static uint8_t parse_date(Time *destination, const char *nmea)
{
    char c0 = *nmea++;

    /* ISO8601 : YYYY-MM-DDTHH:MM:SS.SSSZ
     * NMEA    : DDMMYY
     * Regex   : ([0-3][0-9])([0-1][0-9])([0-9][0-9])
     */

    /* ([0-3][0-9]) */
    if (is_digit_0_to_3(c0))
    {
        destination->date = 10 * (uint8_t)(c0 - '0'); /* D */
        c0 = *nmea++;
    }
    else
    {
        return 1;
    }

    if (is_digit_0_to_9(c0))
    {
        destination->date += (uint8_t)(c0 - '0'); /* D */
        c0 = *nmea++;
    }
    else
    {
        return 1;
    }

    /* ([0-1][0-9]) */
    if (is_digit_0_to_1(c0))
    {
        destination->month = 10 * (uint8_t)(c0 - '0'); /* M */
        c0 = *nmea++;
    }
    else
    {
        return 1;
    }

    if (is_digit_0_to_9(c0))
    {
        destination->month += (uint8_t)(c0 - '0'); /* M */
        c0 = *nmea++;
    }
    else
    {
        return 1;
    }

    /* ([0-9][0-9]) */
    destination->year = 2000; /* Prepend "20" to the year. Hopefully by the year 2100 there will be a
     * better standard than NMEA 0183 and we will never need to change this.
     */
    if (is_digit_0_to_9(c0))
    {
        destination->year += 10 * (uint8_t)(c0 - '0'); /* Y */
        c0 = *nmea++;
    }
    else
    {
        return 1;
    }

    if (is_digit_0_to_9(c0))
    {
        destination->year += (uint8_t)(c0 - '0'); /* Y */
        c0 = *nmea++;
    }
    else
    {
        return 1;
    }
    return 0;
}

static uint8_t parse_extended_date(Time *destination, const char *day, const char *month, const char *year)
{
    uint_fast8_t i;
    char c0;

    /* ISO8601 : YYYY-MM-DDTHH:MM:SS.SSSZ
     * Day     : [0-3][0-9]
     * Month   : [0-1][0-9]
     * Year    : [0-9]{4}
     */

    /* Day */
    c0 = *day++;
    if (is_digit_0_to_3(c0))
    {
        destination->date = 10 * (uint8_t)(c0 - '0');
        c0 = *day++;
    }
    else
    {
        return 1;
    }

    if (is_digit_0_to_9(c0))
    {
        destination->date += (uint8_t)(c0 - '0');
    }
    else
    {
        return 1;
    }

    /* Month */
    c0 = *month++;
    if (is_digit_0_to_1(c0))
    {
        destination->month = 10 * (uint8_t)(c0 - '0');
        c0 = *month++;
    }
    else
    {
        return 1;
    }

    if (is_digit_0_to_9(c0))
    {
        destination->month += (uint8_t)(c0 - '0');
    }
    else
    {
        return 1;
    }

    /* Year */
    c0 = *year++;
    uint16_t factor = 1000;
    destination->year = 0;
    for (i = 0; is_digit_0_to_9(c0) && (i < 4); ++i)
    {
        destination->year += factor * (uint8_t)(c0 - '0');
        c0 = *year++;
        factor /= 10;
    }
    return 0;
}

static int32_t parse_altitude(const char *nmea, const char unit)
{
    /* The unit should always be meters */
    if (unit != 'M') return GPS_INVALID_VALUE;

    return parse_number(nmea);
}

static int32_t parse_track(const char *nmea, const char type)
{
    /* Make sure the track type is true */
    if (type != 'T') return GPS_INVALID_VALUE;

    return parse_number(nmea);
}

static int32_t parse_speed(const char *nmea, const char unit)
{
    int32_t speed;

    /* Process speed differently based on the unit. In all cases, we are
     * converting from some unit to the SI unit of meters per second.
     * K = Kilometers per hour, N = Knots
     */
    switch (unit)
    {
    case 'K':
        speed = parse_number(nmea);
        return (speed * 10) / 36;
    case 'N':
        speed = parse_number(nmea);
        return (speed * 1000) / 1944;
    default:
        break;
    }

    return GPS_INVALID_VALUE;
}

static enum gps_mode parse_mode(const char mode)
{
    switch (mode)
    {
    case '1': return GPS_MODE_NO_FIX;
    case '2': return GPS_MODE_2D_FIX;
    case '3': return GPS_MODE_3D_FIX;
    default: break;
    }

    return GPS_MODE_UNKNOWN;
}

static bool is_status_valid(const char status)
{
    if ('A' == status) return true;
    return false;
}

static uint8_t parse_gga(struct gps_tpv *tpv, const char **token)
{
    if (parse_time(tpv->time, token[0])) return GPS_ERROR_PARSE;
    tpv->latitude = parse_angular_distance(token[1], token[2][0]);
    tpv->longitude = parse_angular_distance(token[3], token[4][0]);
    tpv->altitude = parse_altitude(token[8], token[9][0]);
    return 0;
}

static uint8_t parse_gll(struct gps_tpv *tpv, const char **token)
{
    if (is_status_valid(token[5][0]))
    {
        tpv->latitude = parse_angular_distance(token[0], token[1][0]);
        tpv->longitude = parse_angular_distance(token[2], token[3][0]);
        if (parse_time(tpv->time, token[4])) return GPS_ERROR_PARSE;
        return 0;
    }
    return GPS_ERROR_PARSE;
}

static uint8_t parse_gsa(struct gps_tpv *tpv, const char **token)
{
    tpv->mode = parse_mode(token[1][0]);
    return 0;
}

static uint8_t parse_rmc(struct gps_tpv *tpv, const char **token)
{
    if (is_status_valid(token[1][0]))
    {
        if (parse_time(tpv->time, token[0])) return GPS_ERROR_PARSE;
        tpv->latitude = parse_angular_distance(token[2], token[3][0]);
        tpv->longitude = parse_angular_distance(token[4], token[5][0]);
        tpv->track = parse_track(token[7], 'T');
        tpv->speed = parse_speed(token[6], 'N');
        if (parse_date(tpv->time, token[8])) return GPS_ERROR_PARSE;
        return 0;
    }
    return GPS_ERROR_PARSE;
}

static uint8_t parse_vtg(struct gps_tpv *tpv, const char **token)
{
    tpv->track = parse_track(token[0], token[1][0]);
    tpv->speed = parse_speed(token[6], token[7][0]);
    return 0;
}

static uint8_t parse_zda(struct gps_tpv *tpv, const char **token)
{
    if (parse_time(tpv->time, token[0])) return GPS_ERROR_PARSE;
    if (parse_extended_date(tpv->time, token[1], token[2], token[3])) return GPS_ERROR_PARSE;
    return 0;
}

void gps_init_tpv(struct gps_tpv *tpv)
{
    assert(tpv != NULL);

    tpv->mode      = GPS_MODE_UNKNOWN;
    tpv->altitude  = GPS_INVALID_VALUE;
    tpv->latitude  = GPS_INVALID_VALUE;
    tpv->longitude = GPS_INVALID_VALUE;
    tpv->track     = GPS_INVALID_VALUE;
    tpv->speed     = GPS_INVALID_VALUE;
    tpv->time->date = DEFAULT_DATE;
    tpv->time->month = DEFAULT_MONTH;
    tpv->time->year = DEFAULT_YEAR;
    tpv->time->hours = 0;
    tpv->time->minutes = 0;
    tpv->time->seconds = 0;
    tpv->time->milliseconds = 0;
    memset(tpv->talker_id, '\0', GPS_TALKER_ID_SIZE);
}

char *gps_encode(char *destination, const char *message)
{
    assert(destination != NULL);
    assert(message != NULL);

    uint8_t checksum = 0;
    char c0 = *message++;

    /* Add the header character */
    *destination++ = '$';

    /* Add and compute the checksum for all of the message contents */
    while (c0)
    {
        checksum ^= c0;
        *destination++ = c0;
        c0 = *message++;
    }

    /* Add the end of sentence marker */
    *destination++ = '*';

    /* Add the checksum characters */
    *destination++ = uint8_to_hex_char((checksum & 0xF0) >> 4);
    *destination++ = uint8_to_hex_char( checksum & 0x0F);

    /* Add the footer characters */
    *destination++ = '\r';
    *destination++ = '\n';

    /* NUL terminate the string */
    *destination = '\0';

    return destination;
}

int gps_decode(struct gps_tpv *tpv, char *nmea)
{
    assert(tpv != NULL);
    assert(nmea != NULL);

    parse_function parse;
    char *token[NMEA_MAX_FIELDS];
    uint8_t checksum = 0;
    uint8_t i = 0;
    char c0 = *nmea++;
    char c1;

    /* Check if the first character is the header */
    if (c0 != '$') return GPS_ERROR_HEAD;
    c0 = *nmea++;

    /* Store the talker ID */
    c1 = *nmea++;
    if (!c0 || !c1) return GPS_ERROR_TRUNCATED;
    tpv->talker_id[0] = c0;
    tpv->talker_id[1] = c1;

    /* Compute the checksum thus far */
    checksum ^= c0 ^ c1;

    /* Use the sentence ID to determine which parsing function to use */
    /* TODO: Switch checking for sentences on and off using # defines and a config.h */
    if (memchr(nmea, '\0', SENTENCE_ID_SIZE))
        return GPS_ERROR_TRUNCATED;
    else if (match_sentence_id(nmea, "GGA"))
        parse = parse_gga;
    else if (match_sentence_id(nmea, "GLL"))
        parse = parse_gll;
    else if (match_sentence_id(nmea, "GSA"))
        parse = parse_gsa;
    else if (match_sentence_id(nmea, "RMC"))
        parse = parse_rmc;
    else if (match_sentence_id(nmea, "VTG"))
        parse = parse_vtg;
    else if (match_sentence_id(nmea, "ZDA"))
        parse = parse_zda;
    else
        return GPS_ERROR_UNSUPPORTED;

    /* Advance c0 to the first character in the sentence ID. This also syncs
     * the NMEA string pointer with the current character being processed.
     * This helps to make the tokenizing stage easier to maintain.
     */
    c0 = *nmea;

    /* Tokenize and compute the checksum for the body of the NMEA sentence.
     * Note that tokenizing begins after the first ',' is encountered. This
     * works because the sentence ID is the first string processed and we do
     * not need to store it as a token.
     */
    while (c0 != '*')
    {
        if (!c0) return GPS_ERROR_TRUNCATED;
        checksum ^= c0;
        if (',' == c0)
        {
            *nmea = '\0';
            token[i++] = nmea + 1;
        }
        c0 = (++nmea)[0];
    }

    /* Replace the '*' with a NUL in order to mark the end of the final token
     * in the sentence. Then advance the pointer nmea one position ahead
     * again.
     */
    *nmea++ = '\0';
    c0 = *nmea++;

    /* Validate the checksum */
    c1 = *nmea++;
    if (checksum != build_hex_byte(c0, c1)) return GPS_ERROR_CHECKSUM;
    c0 = *nmea++;

    /* Check for the message footer */
    c1 = *nmea++;
    if ((c0 != '\r') || (c1 != '\n')) return GPS_ERROR_FOOT;

    /* Parse the NMEA sentence tokens */
    if (parse(tpv, (const char **)token))
        return GPS_ERROR_PARSE;

    return GPS_OK;
}

const char *gps_error_string(const int e)
{
    static const char *msg[] = {
        "No error while parsing NMEA",
        "Header '$' missing",
        "Footer CRLF missing",
        "Checksum did not match",
        "Sentence truncated",
        "Unsupported NMEA sentence"
    };

    if ((0 <= e) && (e < ((int)(sizeof(msg) / sizeof(msg[0]))))) return msg[e];
    return "Unknown error";
}
