Alan-JH/precision-clock/(commit log)

2025-11-06 Revert "Initial commit"
    This reverts commit 37d97fef083f5c2f4647276c4944423df487484e.
    [display.kicad_sch, gps.kicad_sch, precision-clock.kicad_pcb, precision-clock.kicad_sch, rtc.kicad_sch]
2025-11-06 Revert "Revert "Initial commit""
    This reverts commit 25a4185e54c432d465cfb9da8a8ced92ea69207e.
    [display.kicad_sch, gps.kicad_sch, precision-clock.kicad_pcb, precision-clock.kicad_sch, rtc.kicad_sch]
2025-11-11 display work
    [display.kicad_sch]
2025-11-12 schematic work done
    [display.kicad_sch, gps.kicad_sch, precision-clock.kicad_sch, rtc.kicad_sch]
2025-11-14 ADC Backup Battery
2025-11-14 board work
    [display.kicad_sch, gps.kicad_sch, precision-clock.kicad_pcb, precision-clock.kicad_sch, rtc.kicad_sch]
2025-11-15 Board Rev 1.0 Release
    [gps.kicad_sch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]
2025-11-18 BOM, CSV, and STEP exports
    [display.kicad_sch, gps.kicad_sch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]
2025-11-18 fix bom and recompress gerbers
    [precision-clock.kicad_sch]
2025-11-21 chatgpt lied about timers
2025-11-21 fix rtc jitter issue
    [ds3231.c, main.c]
2025-11-25 fix timers
